mimok/tsensor-hardware/README.md

# tsensor-hardware
Kicad project of the Tsensor board
