mimok/tsensor-hardware/TSens_macrofab.xlsx

Reference | Manufacturer | Quantity | Manufacturer_Part_Number | Description / Value
C1 C5 C7 | GRM188R60J106KE47D | 3 | GRM188R60J106KE47D | 10uF
C11 C13 C2 C6 C9 C12 C10 | 885012206020 | 7 | MF-CAP-0603-0.1uF | 100nF
C15 | 885012206014 | 1 | MF-CAP-0603-0.01uF | 10nF
C3 | RC0603JR-070RL | 1 | MF-RES-0603-0 | 0R
C8 C17 C14 | C0603C105K8RACTU | 3 | MF-CAP-0603-1uF | 1uF
D1 | LTST-C190KRKT | 1 | MF-LED-0603-RED (https://factory.macrofab.com/part/MF-LED-0603-RED) | MF-LED-0603-RED (https://factory.macrofab.com/part/MF-LED-0603-RED)
D2 | PRTR5V0U2X,215 | 1 | PRTR5V0U2X,215 | PRTR5V0U2X,215
D4 D3 | PMEG2010ER,115 | 2 | PMEG2010ER,115 | PMEG2010ER,115
FB1 | BK0603HS330-T | 1 | BK0603HS330-T | BK0603HS330-T
FL1 | BLM18HG102SN1D | 1 | BLM18HG102SN1D | BLM18HG102SN1D
IC1 | SE050C1HQ1/Z01SCZ | 1 | SE050C1HQ1/Z01SCZ | SE050C1HQ1_Z01SCZ
J1 | M20-9990346 | 1 | MF-CON-2.54mm-01x03 | UART
J2 | SMA-J-P-H-ST-EM1 | 1 | CON-SMA-EDGE-S | SMA
J3 | M20-9990646 | 1 | MF-CON-2.54mm-01x06 | JTAG
J4 | 10118193-0001LF | 1 | MF-CON-MICROUSB-RIGHT | USB_MICRO_RIGHT
J5 | B2B-PH-SM4-TB(LF)(SN) | 1 | B2B-PH-SM4-TB(LF)(SN) | Battery
J6 J7 | M20-7820842 | 2 | M20-7820842 | Conn_01x08
R1 | CRCW0603750RJNEA | 1 | MF-RES-0603-220 | 220R
R2 R3 | CRCW06031K00JNEAC | 2 | MF-RES-0603-1K | 1k
R4 | CRCW06034K70JNEAC | 1 | MF-RES-0603-4.7K | 4K7
R5 | CRCW0603100RJNEAC | 1 | MF-RES-0603-100 | 100R
R6 | CRCW0603100KJNEAC | 1 | MF-RES-0603-100K | 100k
SW1 SW2 | PTS810SJM250SMTRLFS | 2 | MF-SW-TACT-4.2MM (https://factory.macrofab.com/part/MF-SW-TACT-4.2MM) | TACT_4.2MM
U1 | CMWX1ZZABZ-091 | 1 | CMWX1ZZABZ-091 | CMWX1ZZABZ-091
U2 | TLV70233PDBVR | 1 | MF-REG-SOT235-3.3V-300mA | TLV70233PDBVR
R7 R8 |  | 2 | MF-RES-0603-1.69K (https://factory.macrofab.com/part/MF-RES-0603-1.69K) | 1.69k
