mimok/tsensor-hardware/TSens_schematic.pdf

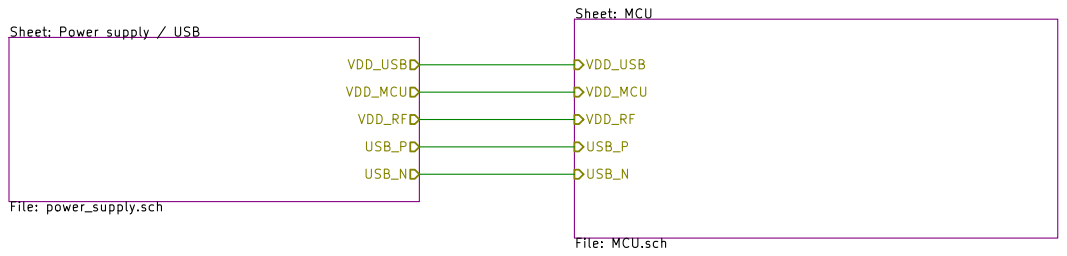
[picture p1: page 1]

VDD_RF Sheet: Power supply / USB

https://hackaday.io/project/171082-tsensor
File: TSens.sch Sheet: / Michael Grand CC BY 4.0

Id: 1/3 Title: TSensor board

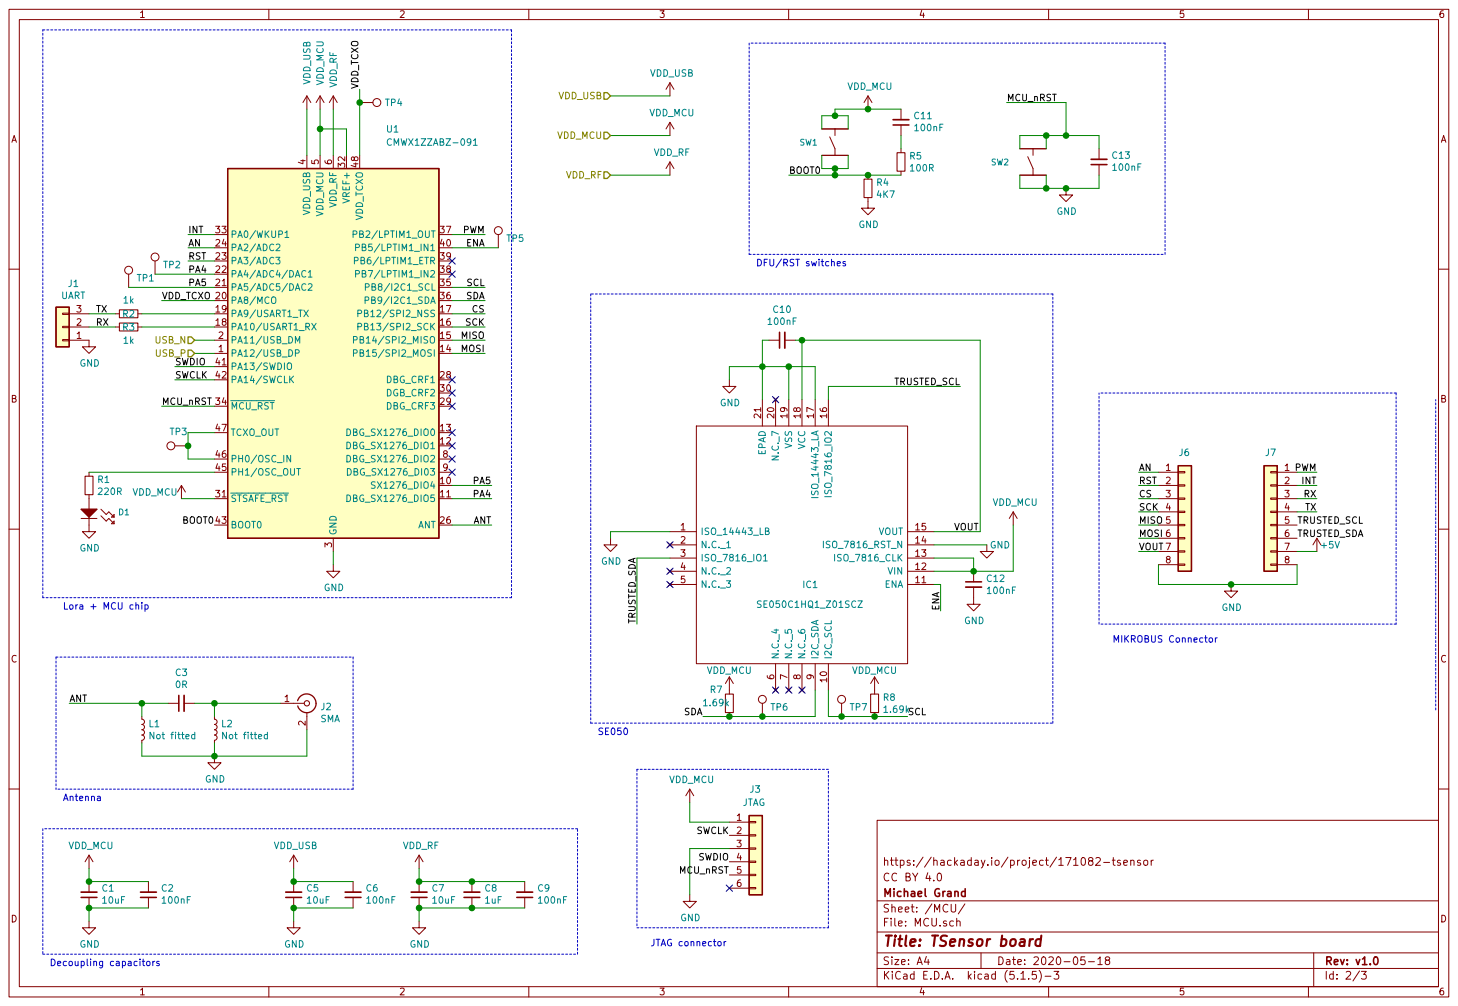
[picture p2: page 2]

1 | R3 | SWDIO

https://hackaday.io/project/171082-tsensor C5

File: MCU.sch Sheet: /MCU/ Michael Grand CC BY 4.0

Id: 2/3 Title: TSensor board

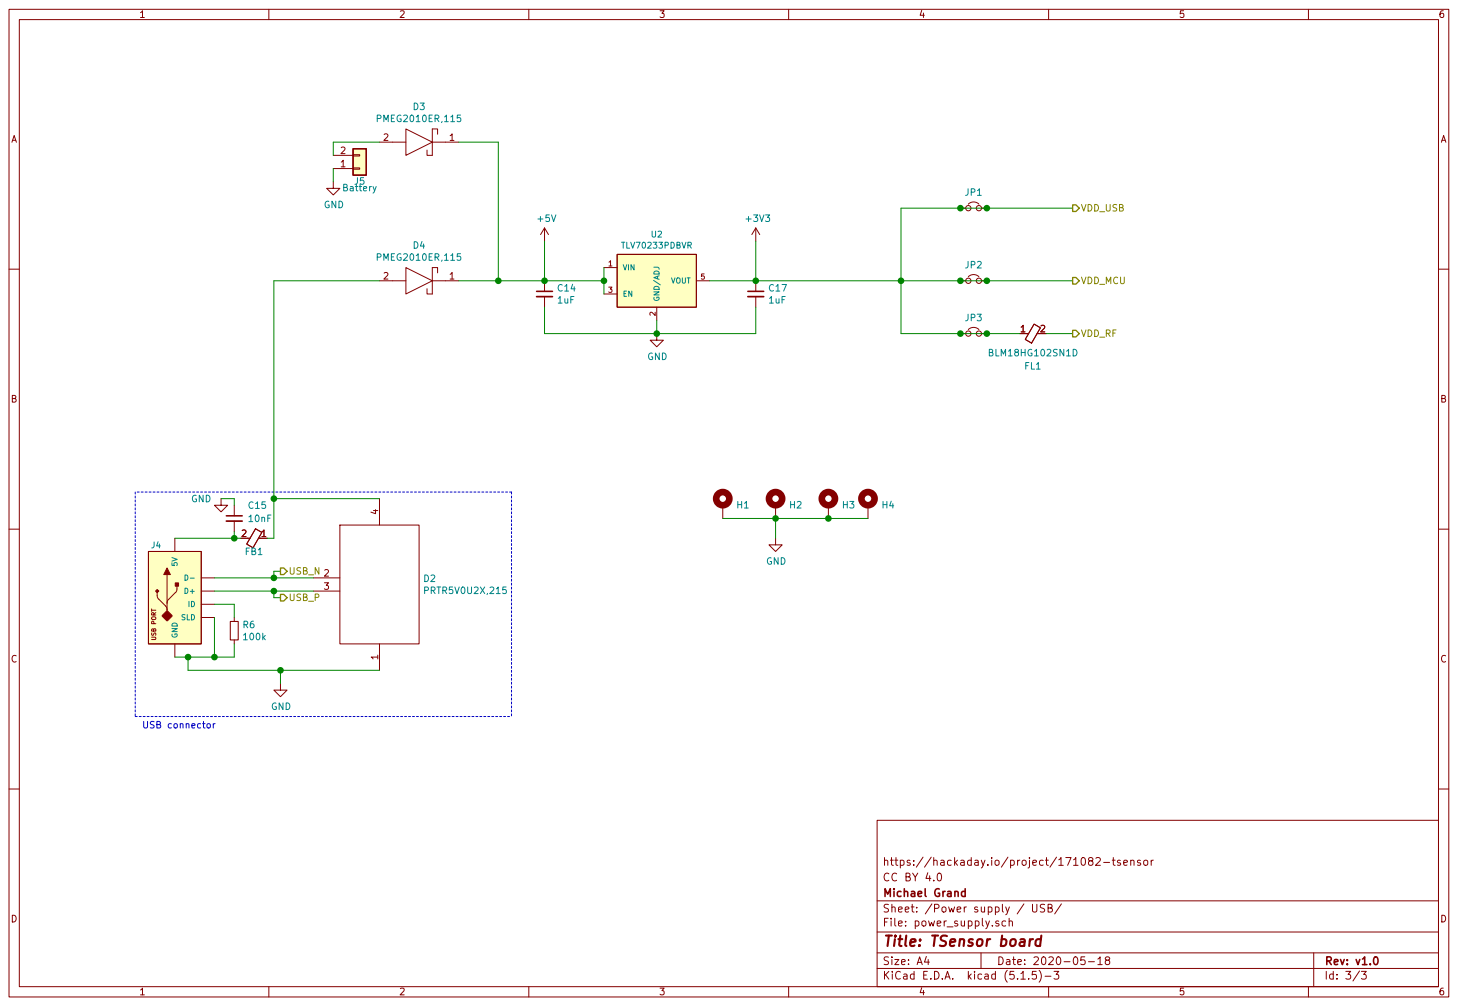
[picture p3: page 3]

https://hackaday.io/project/171082-tsensor
Sheet: /Power supply / USB/ Michael Grand CC BY 4.0

File: power_supply.sch
Id: 3/3 Title: TSensor board
