mimok/tsensor-hardware/TSens.kicad_pcb

## KiCad design TSens.kicad_pcb (2020-05-18)

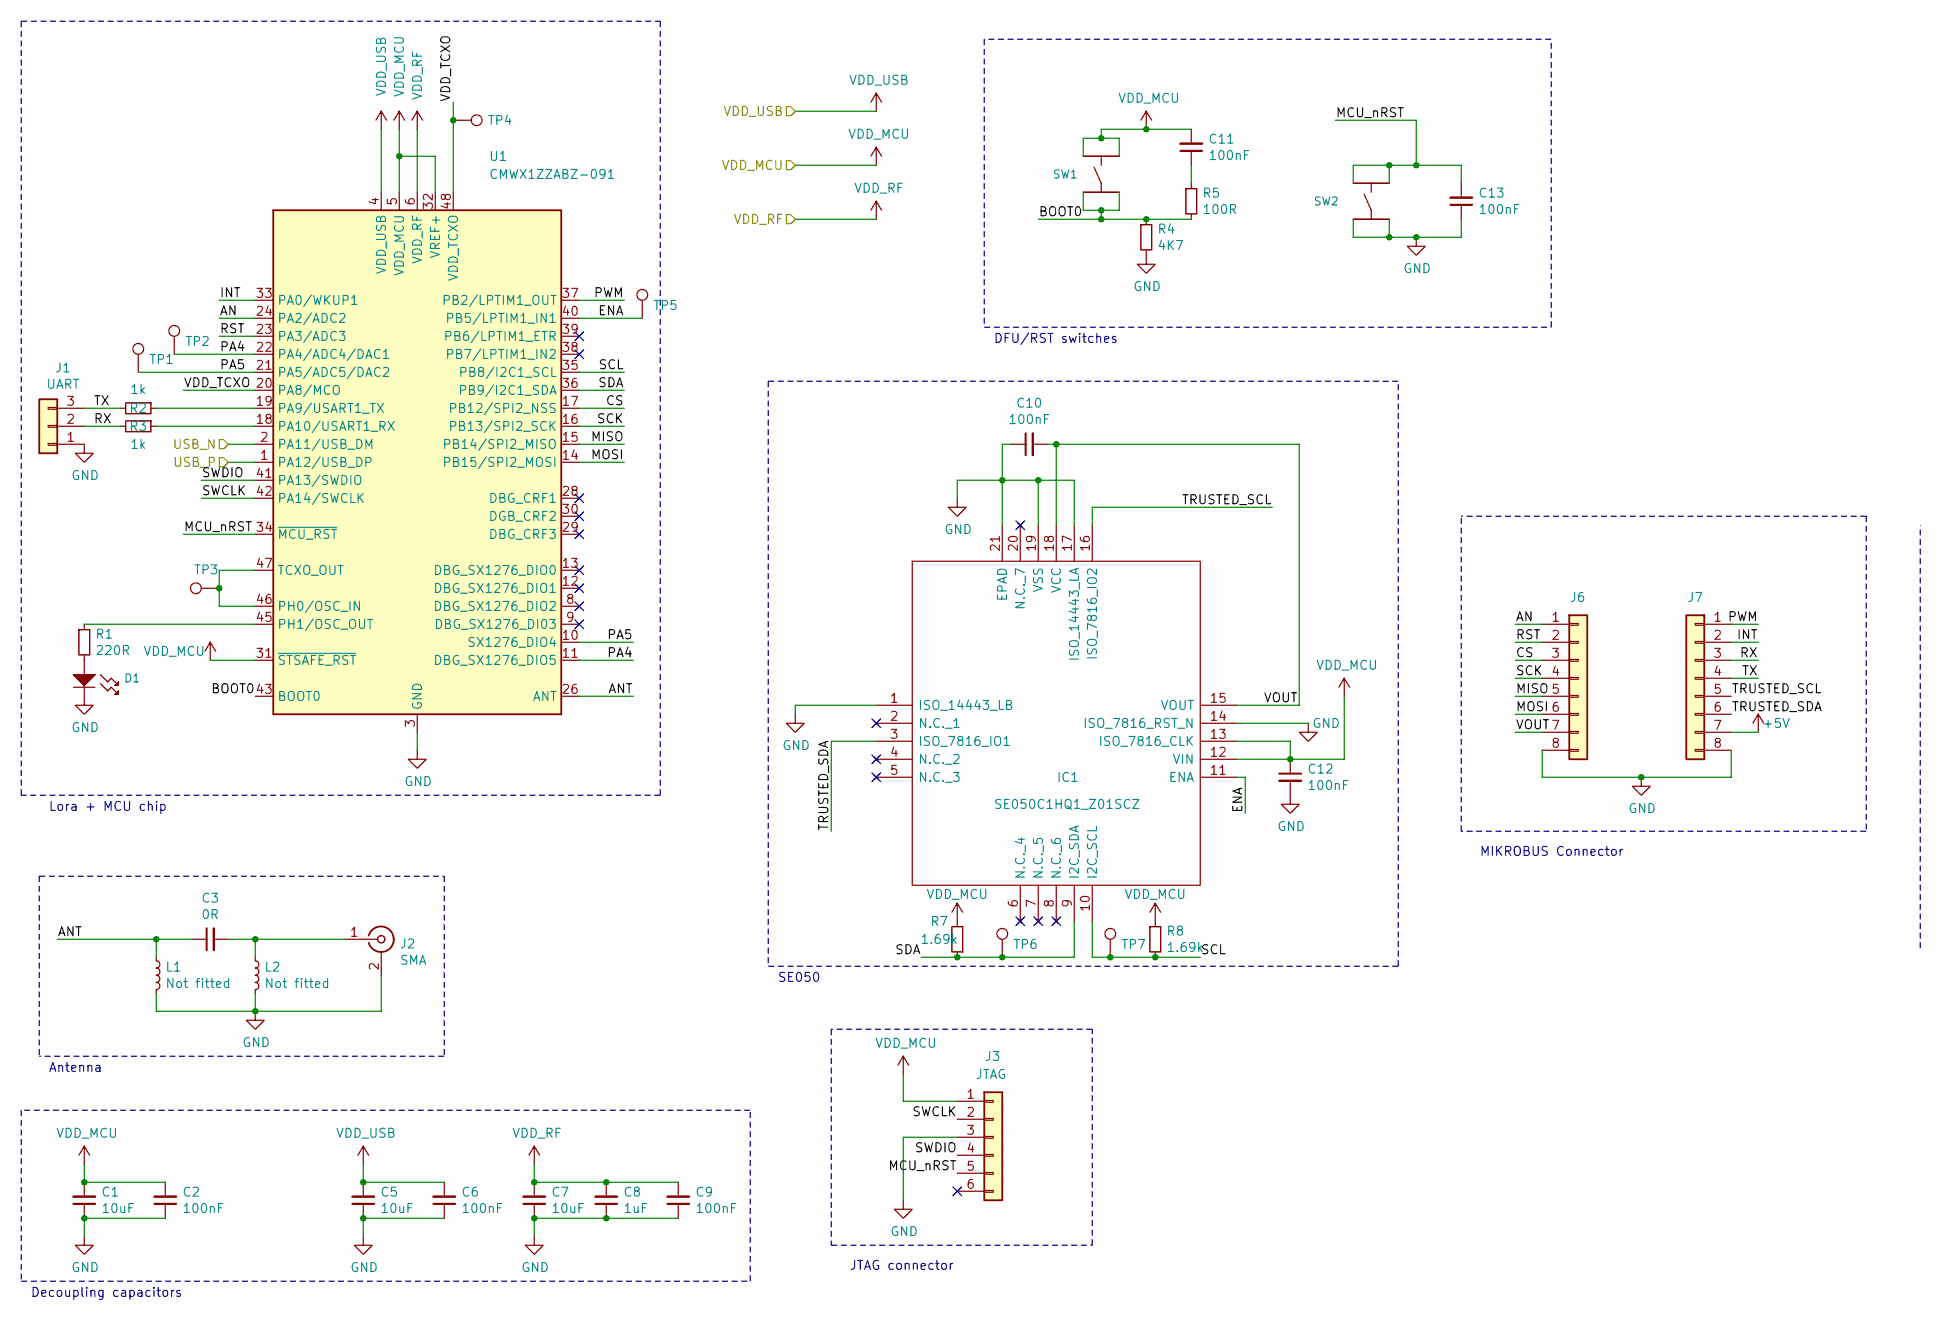
[picture p4: schematic MCU.sch, TSensor board]

Parts:
C1, C5, C7: 10uF; C_0603; Manufacturer_Part_Number GRM188R60J106KE47D; Mouser Part Number 81-GRM188R60J106KE7D
C2, C6, C9, C10, C11, C12, C13: 100nF; C_0603; Manufacturer_Part_Number 885012206020; Mouser Part Number 710-885012206020
C3: 0R; R_0603; Manufacturer_Part_Number RC0603JR-070RL; Mouser Part Number 603-RC0603JR-070RL
C8: 1uF; C_0603; Manufacturer_Part_Number C0603C105K8RACTU; Mouser Part Number 80-C0603C105K8RACTU
D1: LED_SINGLE-0603-RED; MF_LEDs-LED0603
IC1: SE050C1HQ1_Z01SCZ; QFN40P300X300X33-21N-D; Manufacturer_Part_Number SE050C1HQ1/Z01SCZ; Mouser Part Number 771-SE050C1HQ1Z01SCZ
J1: UART; PinHeader_1x03_P2.54mm_Vertical; Manufacturer_Part_Number M20-9990346; Mouser Part Number 855-M20-9990346
J2: SMA; SMA_Samtec_SMA-J-P-X-ST-EM1_EdgeMount; Manufacturer_Part_Number SMA-J-P-H-ST-EM1; Mouser Part Number 200-SMAJPHSTEM1
J3: JTAG; PinHeader_1x06_P2.54mm_Vertical; Manufacturer_Part_Number M20-9990646; Mouser Part Number 855-M20-9990646
J6, J7: Conn_01x08; PinSocket_1x08_P2.54mm_Vertical
L1, L2: Not fitted; L_0603
R1: 220R; R_0603; Manufacturer_Part_Number CRCW0603750RJNEA; Mouser Part Number 71-CRCW0603J-750-E3
R2, R3: 1k; R_0603; Manufacturer_Part_Number CRCW06031K00JNEAC; Mouser Part Number 71-CRCW06031K00JNEAC
R4: 4K7; R_0603; Manufacturer_Part_Number CRCW06034K70JNEAC; Mouser Part Number 71-CRCW06034K70JNEAC
R5: 100R; R_0603; Manufacturer_Part_Number CRCW0603100RJNEAC; Mouser Part Number 71-CRCW0603100RJNEAC
R7, R8: 1.69k; R_0603
SW1, SW2: TACT_4.2MM; MF_Switches-TACT4.2MM
TP1, TP2, TP3, TP4, TP5, TP6, TP7: TestPoint; TestPoint_Pad_D1.0mm
U1: CMWX1ZZABZ-091; MODULE_CMWX1ZZABZ-091; Manufacturer_Part_Number CMWX1ZZABZ-091; Mouser Part Number 81-CMWX1ZZABZ-091

Connections:
+3V3: C1.2, C2.2, C5.2, C6.2, C11.2, C12.1, IC1.12 (VIN), IC1.13 (ISO_7816_CLK), J3.1, R7.2, R8.1, SW1.1, SW1.2, U1.4 (VDD_USB), U1.5 (VDD_MCU), U1.31 (~STSAFE_RST), U1.32 (VREF+); also elsewhere on the board
+5V: J7.7; also elsewhere on the board
/MCU/AN: J6.1, U1.24 (PA2/ADC2)
/MCU/ANT: C3.1, L1.1, U1.26 (ANT)
/MCU/BOOT0: R4.1, R5.2, SW1.3, SW1.4, U1.43 (BOOT0)
/MCU/CS: J6.3, U1.17 (PB12/SPI2_NSS)
/MCU/ENA: IC1.11 (ENA), TP5.1, U1.40 (PB5/LPTIM1_IN1)
/MCU/INT: J7.2, U1.33 (PA0/WKUP1)
/MCU/MCU_nRST: C13.2, J3.5, SW2.1, SW2.2, U1.34 (~MCU_RST)
/MCU/MISO: J6.5, U1.15 (PB14/SPI2_MISO)
/MCU/MOSI: J6.6, U1.14 (PB15/SPI2_MOSI)
/MCU/PA4: TP2.1, U1.11 (DBG_SX1276_DIO5), U1.22 (PA4/ADC4/DAC1)
/MCU/PA5: TP1.1, U1.10 (SX1276_DIO4), U1.21 (PA5/ADC5/DAC2)
/MCU/PWM: J7.1, U1.37 (PB2/LPTIM1_OUT)
/MCU/RST: J6.2, U1.23 (PA3/ADC3)
/MCU/RX: J1.2, J7.3, R3.2
/MCU/SCK: J6.4, U1.16 (PB13/SPI2_SCK)
/MCU/SCL: IC1.10 (I2C_SCL), R8.2, TP7.1, U1.35 (PB8/I2C1_SCL)
/MCU/SDA: IC1.9 (I2C_SDA), R7.1, TP6.1, U1.36 (PB9/I2C1_SDA)
/MCU/SWCLK: J3.2, U1.42 (PA14/SWCLK)
/MCU/SWDIO: J3.4, U1.41 (PA13/SWDIO)
/MCU/TRUSTED_SCL: IC1.16 (ISO_7816_IO2), J7.5
/MCU/TRUSTED_SDA: IC1.3 (ISO_7816_IO1), J7.6
/MCU/TX: J1.3, J7.4, R2.2
/MCU/USB_N: U1.2 (PA11/USB_DM); also elsewhere on the board
/MCU/USB_P: U1.1 (PA12/USB_DP); also elsewhere on the board
/MCU/VDD_TCXO: TP4.1, U1.20 (PA8/MCO), U1.48 (VDD_TCXO)
/MCU/VOUT: C10.2, IC1.15 (VOUT), IC1.18 (VCC), J6.7
GND: C1.1, C2.1, C5.1, C6.1, C7.1, C8.1, C9.1, C10.1, C12.2, C13.1, D1.CATH (CATHODE), IC1.1 (ISO_14443_LB), IC1.14 (ISO_7816_RST_N), IC1.17 (ISO_14443_LA), IC1.19 (VSS), IC1.21 (EPAD), J1.1, J2.2 (Ext), J3.3, J6.8, J7.8, L1.2, L2.2, R4.2, SW2.3, SW2.4, U1.3 (GND), U1.7 (GND), U1.25 (GND), U1.27 (GND), U1.44 (GND), U1.49 (GND), U1.50 (GND), U1.51 (GND), U1.52 (GND), U1.53 (GND), U1.54 (GND), U1.55 (GND), U1.56 (GND), U1.57 (GND); also elsewhere on the board
unnamed: C3.2, J2.1 (In), L2.1
unnamed: C11.1, R5.1
unnamed: D1.ANOD (ANODE), R1.2
unnamed: R1.1, U1.45 (PH1/OSC_OUT)
unnamed: R2.1, U1.19 (PA9/USART1_TX)
unnamed: R3.1, U1.18 (PA10/USART1_RX)
unnamed: TP3.1, U1.46 (PH0/OSC_IN), U1.47 (TCXO_OUT)
VDD_RF: C7.2, C8.2, C9.2, U1.6 (VDD_RF); also elsewhere on the board

Notes on the sheet:
DFU/RST switches
Decoupling capacitors
MIKROBUS Connector
JTAG connector
Antenna
SE050
Lora + MCU chip

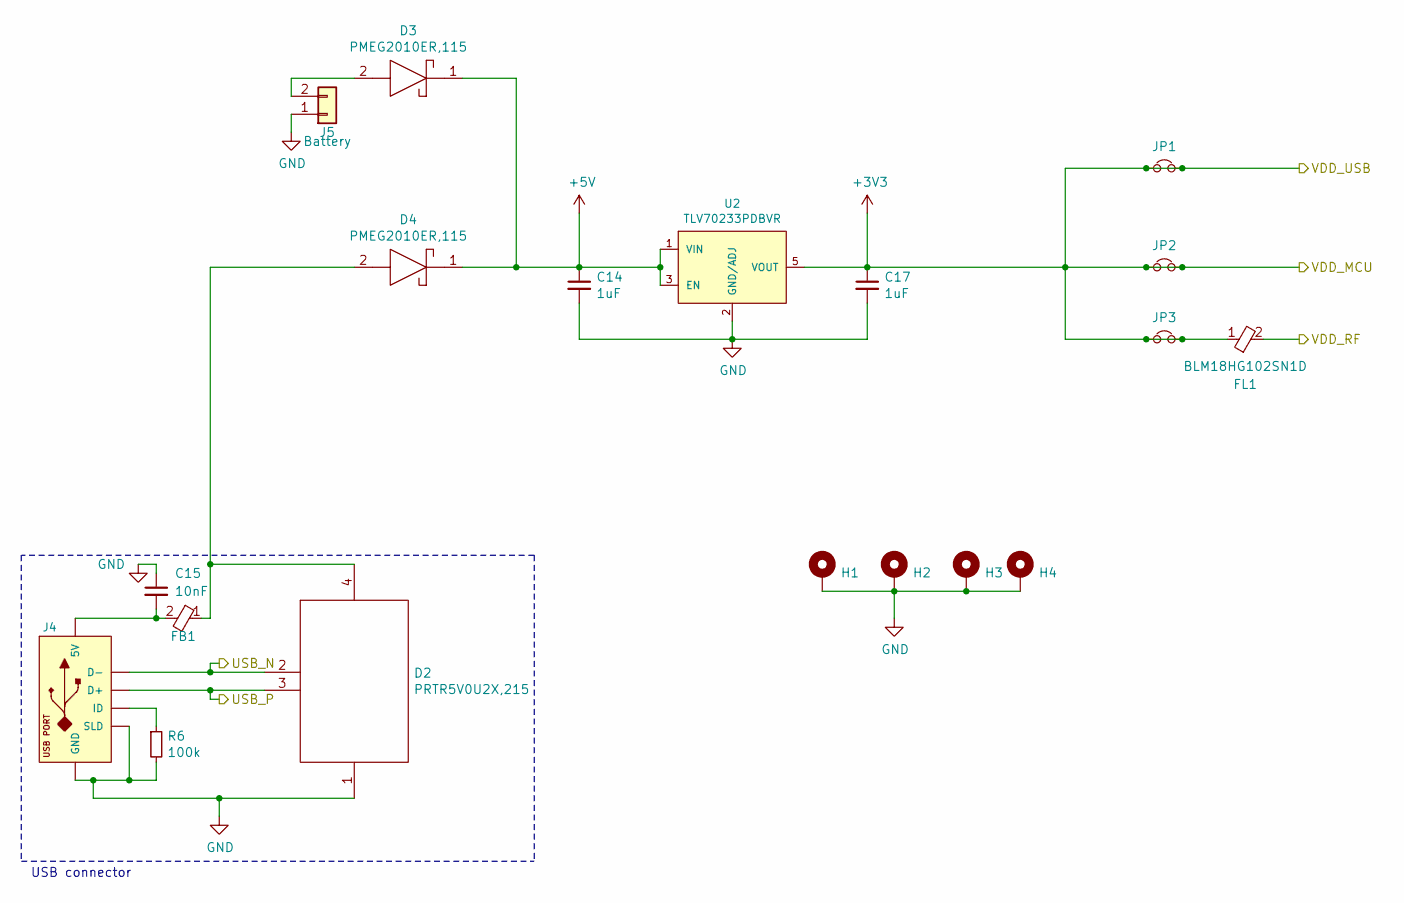
[picture p5: schematic power_supply.sch, TSensor board]

Parts:
C14, C17: 1uF; C_0603; Manufacturer_Part_Number C0603C105K8RACTU; Mouser Part Number 80-C0603C105K8RACTU
C15: 10nF; C_0603; Manufacturer_Part_Number 885012206014; Mouser Part Number 710-885012206014
D2: PRTR5V0U2X,215; SOT-143B; Mouser Part Number 771-PRTR5V0U2X-T/R
D3, D4: PMEG2010ER,115; SODFL3517X110N; Mouser Part Number 771-PMEG2010ER115
FB1: BK0603HS330-T; BEADC0603X33N; Mouser Part Number 963-BK0603HS330-T
FL1: BLM18HG102SN1D; BEADC1608X95N; Mouser Part Number 81-BLM11HA102SG
H1, H2, H3, H4: MountingHole_Pad; MountingHole_2.2mm_M2
J4: USB_MICRO_RIGHT; MF_Connectors-MICROUSB-RIGHT
J5: Battery; JST_PH_B2B-PH-SM4-TB_02x2.00mm_Straight; Manufacturer_Part_Number B2B-PH-SM4-TB(LF)(SN)
JP1, JP2, JP3: Jumper_NC_Small; PinHeader_1x02_P2.54mm_Vertical; Manufacturer_Part_Number M20-9990246; Mouser Part Number 855-M20-9990246
R6: 100k; R_0603; Manufacturer_Part_Number CRCW0603100KJNEAC; Mouser Part Number 71-CRCW0603100KJNEAC
U2: TLV70233PDBVR; MF_IC_Power-SOT-23-5

Connections:
+3V3: C17.1, FL1.1, JP1.1, JP1.2, JP2.1, JP2.2, JP3.1, JP3.2, U2.5 (VOUT); also elsewhere on the board
+5V: C14.1, D3.1, D4.1, U2.1 (VIN), U2.3 (EN); also elsewhere on the board
/MCU/USB_N: D2.2, J4.2 (D-); also elsewhere on the board
/MCU/USB_P: D2.3, J4.3 (D+); also elsewhere on the board
GND: C14.2, C15.1, C17.2, D2.1, H1.1, H2.1, H3.1, H4.1, J4.5 (GND), J4.S1 (SLD), J4.S2 (SLD), J4.S3 (SLD), J4.S4 (SLD), J4.S5 (SLD), J4.S6 (SLD), J5.1, R6.2, U2.2 (GND/ADJ); also elsewhere on the board
unnamed: C15.2, FB1.2, J4.1 (5V)
unnamed: D2.4, D4.2, FB1.1
unnamed: D3.2, J5.2
unnamed: J4.4 (ID), R6.1
VDD_RF: FL1.2; also elsewhere on the board

Notes on the sheet:
USB connector

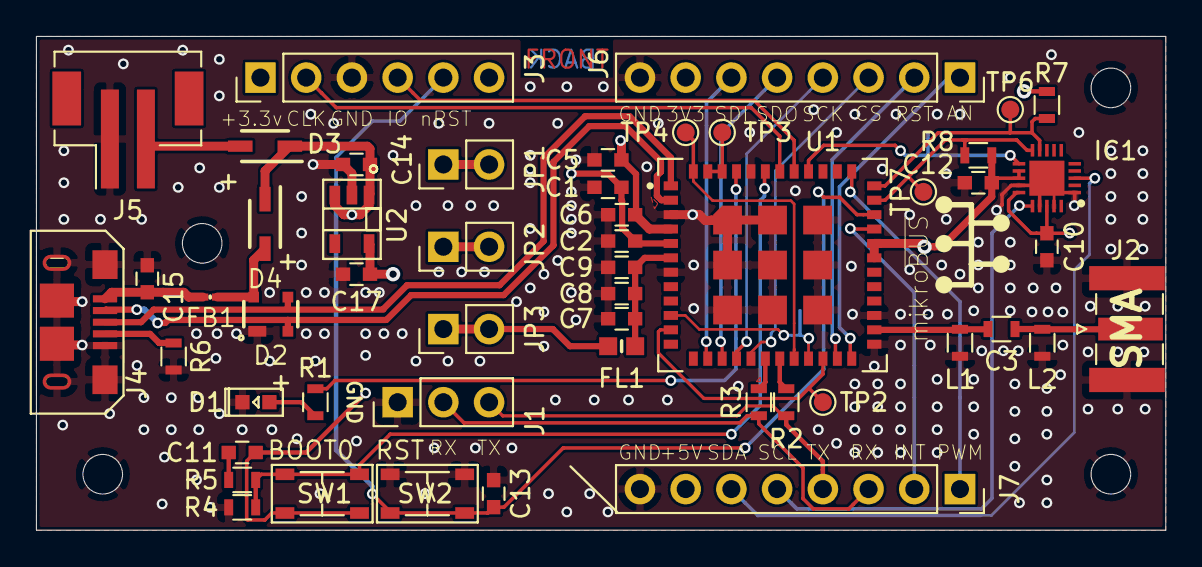
[picture p6: board TSens.kicad_pcb from above]

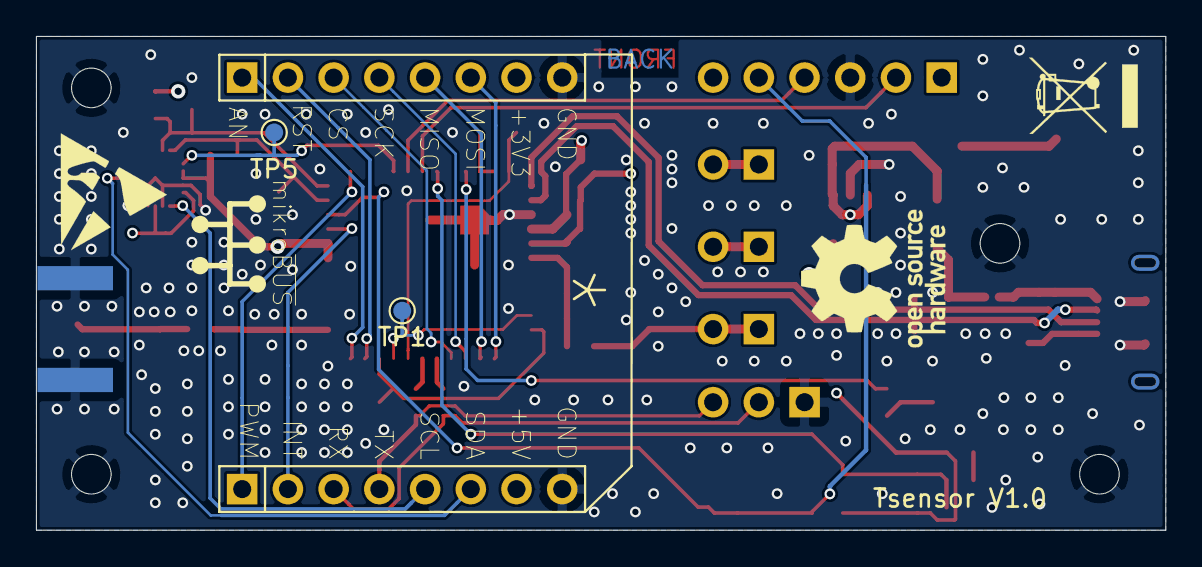
[picture p7: board TSens.kicad_pcb from below]

Board: 4 copper layers, 62.7 x 27.4 mm, 58 parts (2 on the bottom side), 41 nets.

Other parts of the board:
CON1: MIKROBUS_HOST_CONN; MIKROBUS_CONN
